andrewkruger/CHAD/CHAD_Motor.ino

// This code is for the Arduino motor-controller in the Controlled
// Heading Automation Device (CHAD) built by Andrew Kruger and
// students in the Physics 295 Independent Research course at
// Wright College
// Instructions and information found at http://physi.cz/chad


// Adafruit Motorshield v2
#include <AccelStepper.h>
#include <Wire.h>
#include <Adafruit_MotorShield.h>
#include "utility/Adafruit_PWMServoDriver.h"

Adafruit_MotorShield AFMStop(0x60); // Default address, no jumpers

// Connect to stepper on the shield
Adafruit_StepperMotor *myStepper = AFMStop.getStepper(200, 1);

// you can change these to DOUBLE or INTERLEAVE or MICROSTEP!
void forwardstep() { myStepper->onestep(FORWARD, DOUBLE); }
void backwardstep() { myStepper->onestep(BACKWARD, DOUBLE); }

// Wrap the 3 steppers in an AccelStepper object
AccelStepper stepper(forwardstep, backwardstep);

// Set up variables for rotational speed correction
float rotSpeed;               //Input angular speed
String rotSpeed_str;          //For converting incoming string
float rotSpeedScale = .27;    //SCALE ROTATION CORRECTION <-------------------
                              //Found experimentally, this may need to change.
                              //See http://physi.cz/

// Set up variables for heading
float gammaPos;               //Input heading from gamma
int gammaPosSteps;            //Convert units to motor steps
int heading;                  //Desired heading
const float DegToSteps = 0.555556;  //Degree to Motor steps conversion
                                     //Found by (#steps/360deg)
int startingPosition;         
long curPos;
int amtMove;                  //Number of steps motor should move

bool blinkState = false;      //Used to verify program active


void setup()
{
	AFMStop.begin();                // Start the top shield
	Serial.begin(38400);            // AHRS uses 38400 baud
	stepper.setMaxSpeed(5000.0);    //steps/sec, high value is limited by time
	                                //taken to call run()
	stepper.setAcceleration(200.0); //steps/sec^2
	heading = 0 * DegToSteps;       // In units of motor steps
	                                // if it does not begin with gamma at 0
	startingPosition = (Serial.parseFloat() * DegToSteps);
  Serial.println("Setup complete.");
}


void loop()
{
  if (Serial.available() > 0)
    { 
      // Read serial data from AHRS
      rotSpeed_str = Serial.readStringUntil(',');
      rotSpeed = rotSpeed_str.toInt();
      gammaPos = -Serial.parseFloat(); 
      gammaPosSteps = gammaPos * DegToSteps;  //Convert to steps
      curPos = stepper.currentPosition() - startingPosition ;  //Get current position
      amtMove = -gammaPosSteps - (curPos % 200) + rotSpeed*rotSpeedScale; //Calculate ammount moved
                        
      //if the amount to move is less than -180deg, that is it will rotate more than half way
      if (amtMove < -100) { amtMove+=200; }
      //if the amount to move is greater than 180deg, that is it will rotate more than half way
      if (amtMove >= 100) { amtMove-=200; }
      amtMove = amtMove % 200;

      stepper.move(amtMove);  //Set amount to move	
      stepper.run();          //Move
      serialFlush();          //Clear serial memory
	  
      //Blink LED to show data is being received and processed
      blinkState = !blinkState; 
      digitalWrite(13, blinkState); 
      stepper.run();          //Move
    }
  stepper.run();  //Move
}


void serialFlush()
{
  while (Serial.available() > 0) {
    char t = Serial.read();
  }
}
